Variom/laser-projector/README.md

# laser-projector
The objective of this project is to make a visual ambience equipment which uses lasers and that is intended to be used during parties.
For more information please refer to the specifications.
