Variom/laser-projector/slides.pdf

# PROJECTEUR LASER

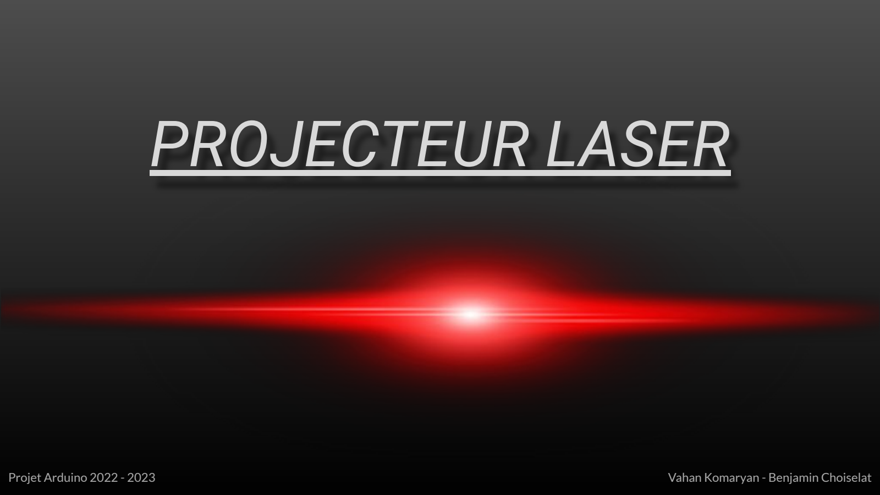
[picture p15: page 1]

Projet Arduino 2022 - 2023 | Vahan Komaryan - Benjamin Choiselat

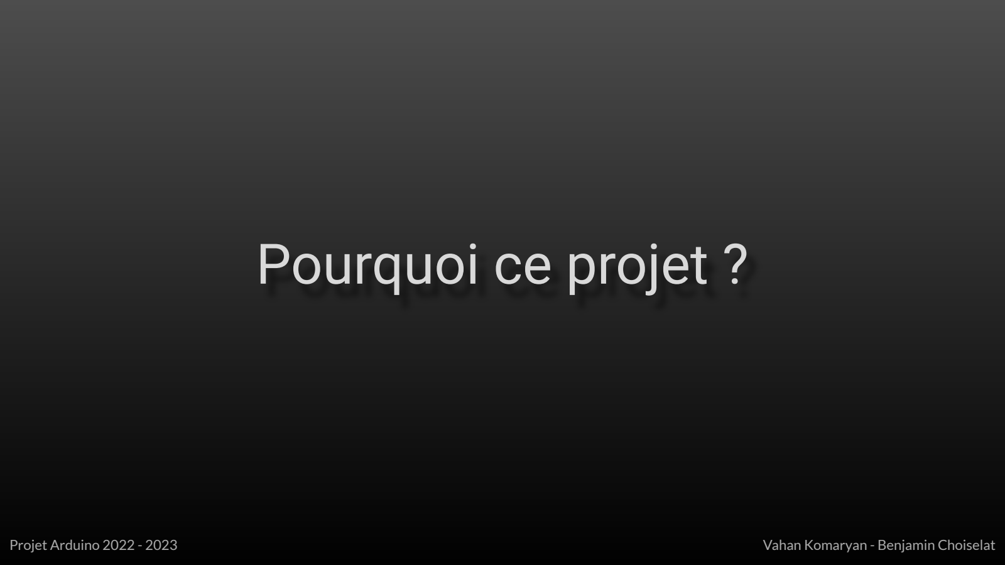
[picture p16: page 2]

# Pourquoi ce projet ?

# Objectif du projet

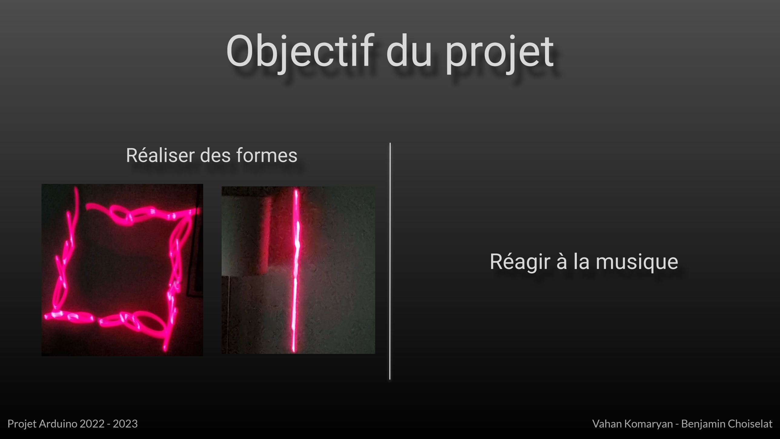
[picture p17: page 3]

# Réaliser des formes

# Réagir à la musique

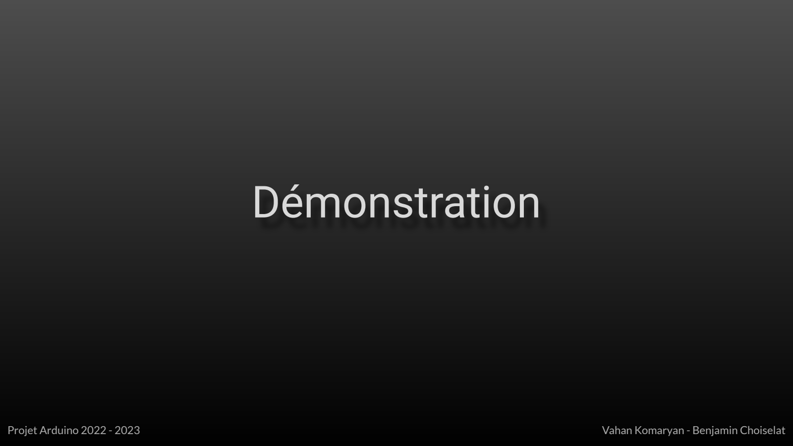
[picture p18: page 4]

# Démonstration

# Fonctionnement

# Moteurs

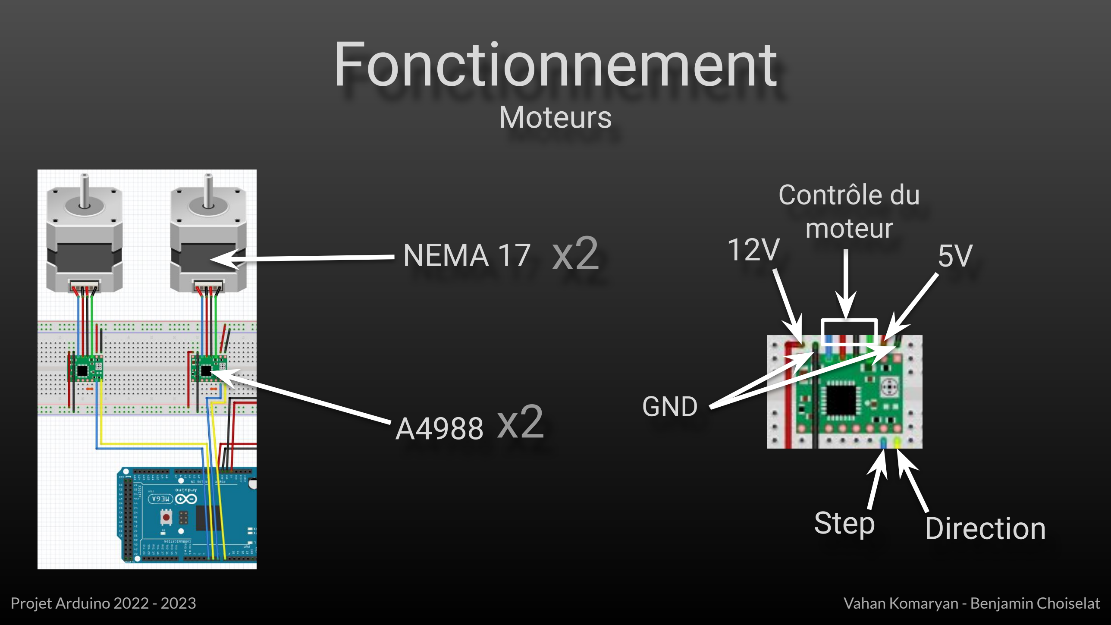
[picture p19: page 5]

# NEMA 17

A4988

12V | 5V
Step | Direction

# Contrôle du moteur

# GND

x2

x2

# Fonctionnement

# Calibrage

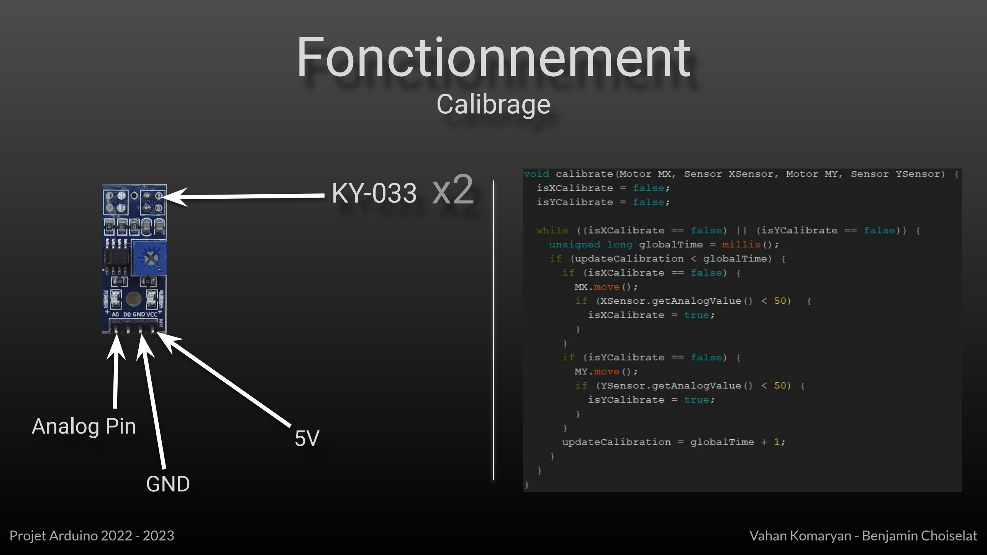
[picture p20: page 6]

KY-033

## Analog Pin

## GND

5V

x2

# Fonctionnement

# Réaction à la musique

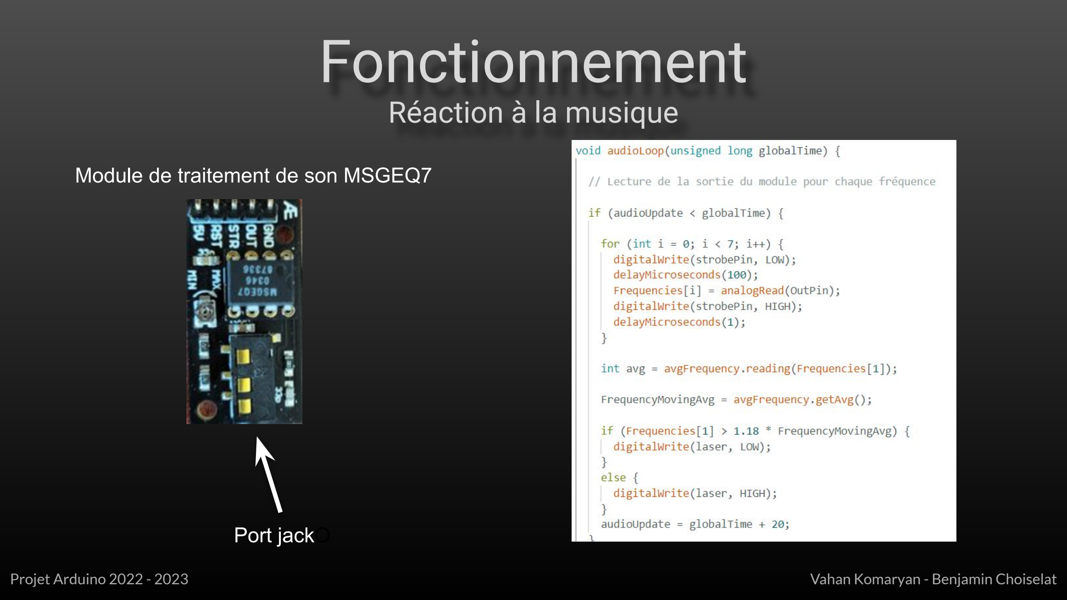
[picture p21: page 7]

## Port jackO

## Module de traitement de son MSGEQ7

# Fonctionnement

# Menu et connectiques

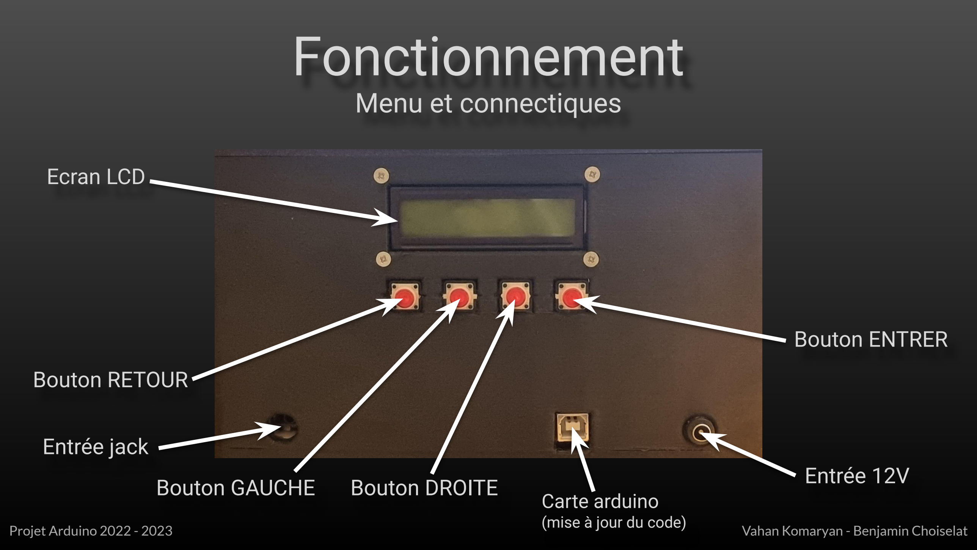
[picture p22: page 8]

## Ecran LCD

## Bouton RETOUR

## Bouton GAUCHE Bouton DROITE

## Bouton ENTRER

## Carte arduino

(mise à jour du code)

## Entrée 12V

## Entrée jack

# Fonctionnement

# Schéma global

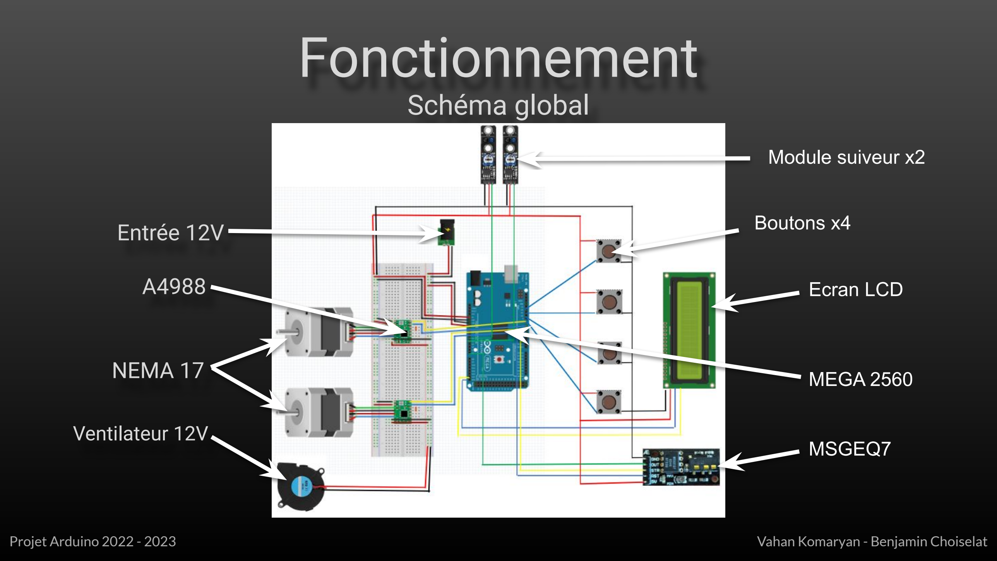
[picture p23: page 9]

## NEMA 17

## Ecran LCD

## Ventilateur 12V

A4988

## MSGEQ7

Entrée 12V | Boutons x4 Module suiveur x2

## MEGA 2560

# Difficultés rencontrées

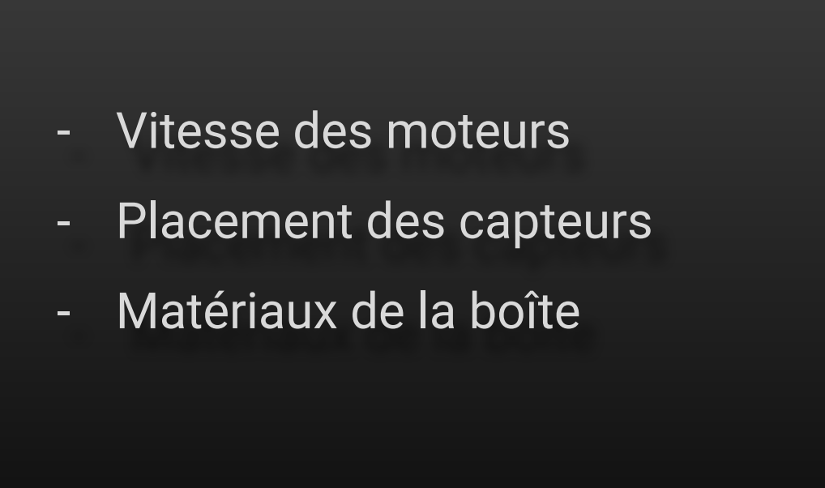
[picture p24: figure]
- Vitesse des moteurs; - Placement des capteurs; - Matériaux de la boîte

# Possibilités d’amélioration

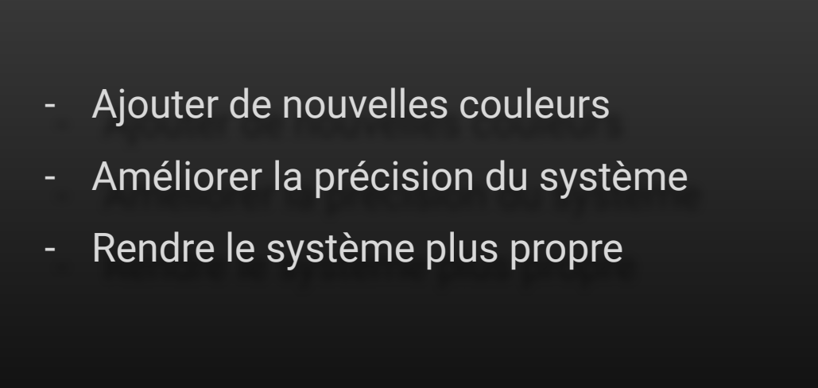
[picture p25: figure]
- Ajouter de nouvelles couleurs; - Améliorer la précision du système; - Rendre le système plus propre

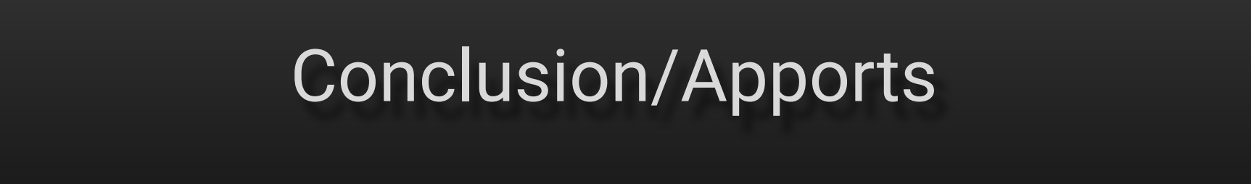
[picture p26: figure]
Conclusion/Apports
